cho45/AVR-TinyElekey/circuit/tinyek.brd

## EAGLE design circuit/tinyek.brd (2013-11-07)

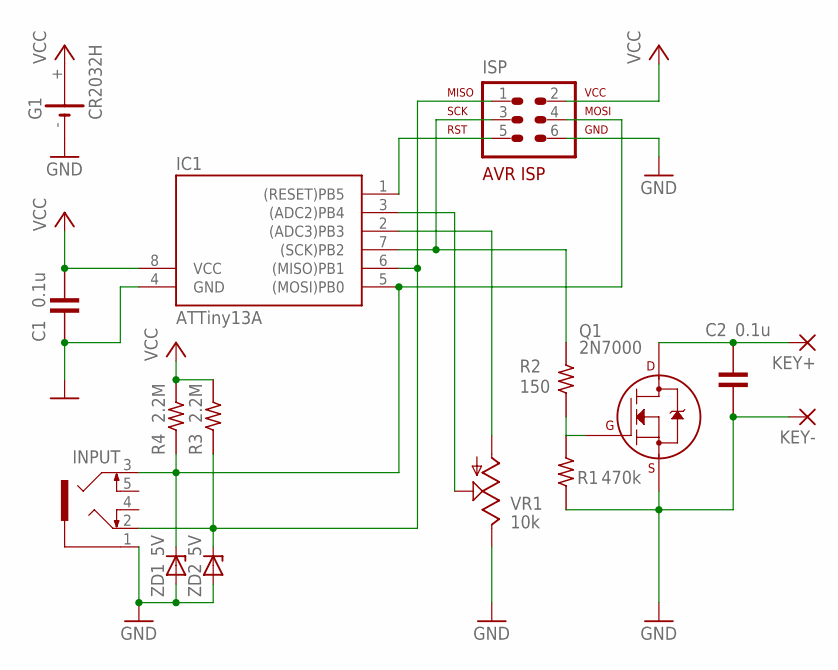
[picture p1: schematic tinyek.sch]

Parts:
C1, C2: 0.1u; 50-0302-5.08
G1: CR2032H
IC1: ATTiny13A; DIL08
INPUT: 1503_09
ISP: AVR-ISP-6VERT; AVR-ISP-6
KEY+: 2,15/1,0
KEY-: 2,15/1,0
Q1: 2N7000; TO-92
R1: 470k; 1/4W-2.54V
R2: 150; 1/4W-2.54V
R3, R4: 2.2M; 1/4W-7.62H
VR1: 10k; B25U
ZD1, ZD2: 5V; DO35Z10

Connections:
GND: C1.PAD1 (1), C2.PAD2 (2), G1.-, IC1.4 (GND), INPUT.1, ISP.6, KEY-.1, Q1.1 (S), R1.PAD2 (2), VR1.E, ZD1.A, ZD2.A
unnamed: IC1.1 ((RESET)PB5), ISP.5
unnamed: IC1.7 ((SCK)PB2), ISP.3, R2.PAD1 (1)
unnamed: IC1.2 ((ADC3)PB3), VR1.A
unnamed: IC1.3 ((ADC2)PB4), VR1.S
unnamed: Q1.2 (G), R1.PAD1 (1), R2.PAD2 (2)
unnamed: C2.PAD1 (1), KEY+.1, Q1.3 (D)
unnamed: IC1.5 ((MOSI)PB0), INPUT.3, ISP.4, R4.PAD2 (2), ZD1.C
unnamed: IC1.6 ((MISO)PB1), INPUT.2, ISP.1, R3.PAD2 (2), ZD2.C
VCC: C1.PAD2 (2), G1.+, IC1.8 (VCC), ISP.2, R3.PAD1 (1), R4.PAD1 (1)

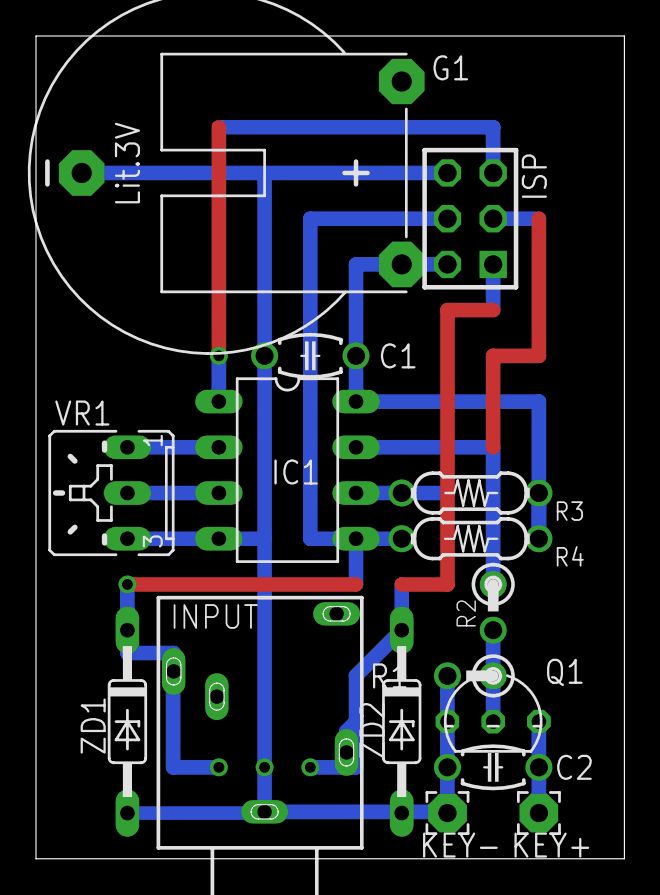
[picture p2: board tinyek.brd from above]

Board: 2 copper layers, 32.7 x 45.7 mm, 16 parts (0 on the bottom side), 10 nets.
