cho45/AVR-TinyElekey/(commit log)

2013-10-29 省電力化 (ADC中以外はボリュームに電流を流さない)
2013-10-30 うーん……… やっぱりときどきおかしいのでリセットをかけるように
2013-11-01 プルアップ抵抗を外部に出して消費電力おさえ
2013-11-05 ADC sleep
2013-11-07 ピンによってドライブ能力が違うので、一応余裕がある配置に設計変更。ほんと意味はないと思う
    [tinyek.brd, tinyek.sch]
2013-11-07 測定しなおし
2013-11-07 update circuit
    [tinyek.sch]
2013-11-07 電流制限抵抗を追加
    [tinyek.brd, tinyek.sch]
